aataiyeb/buck_converter/simulation/README.md

# Simulation

LTspice model of the buck converter: 12V in, 220µH inductor (0.16Ω series resistance), 220µF output
capacitor (56mΩ ESR), 10Ω load, 50kHz switching, 41.7% duty cycle.

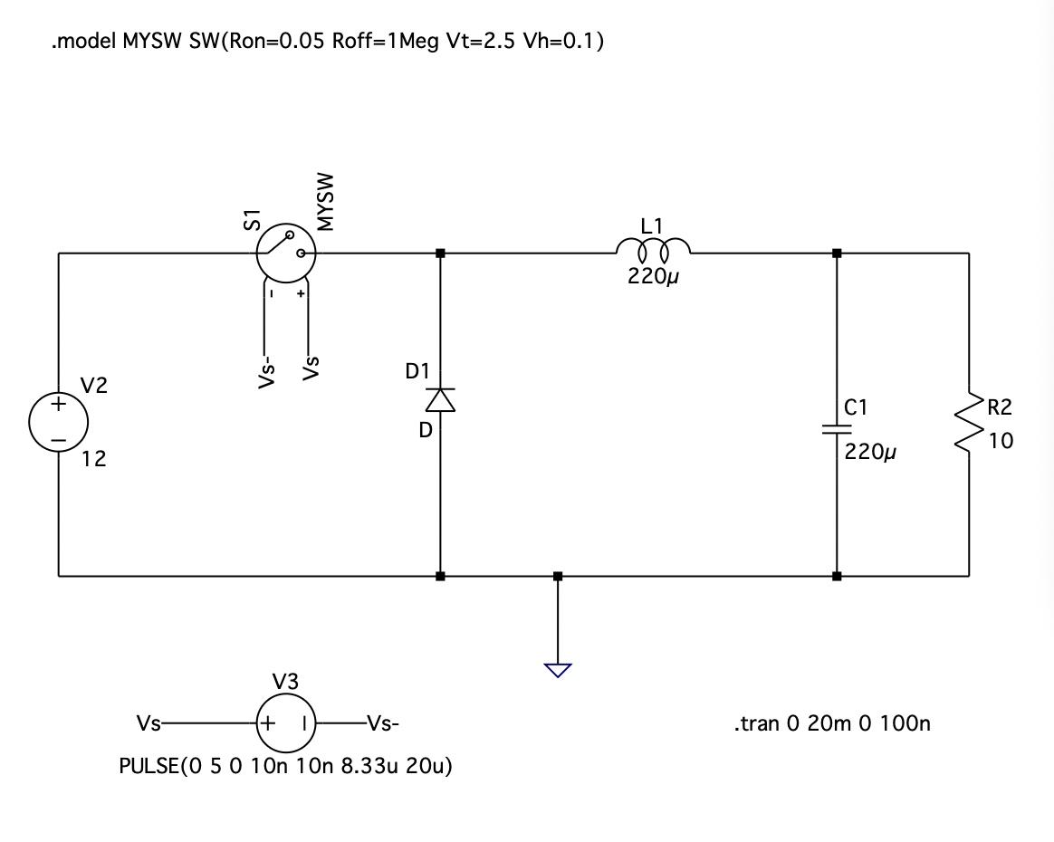
[picture p26: simulation/schematic.png]
Schematic

Schematic with the component values.

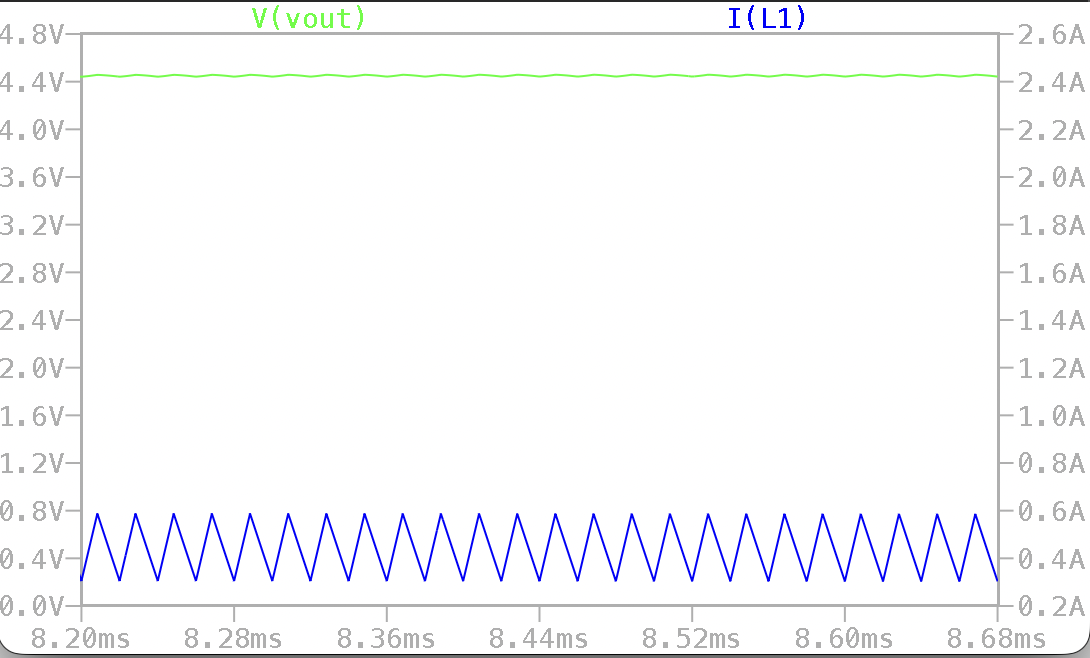
[picture p27: simulation/steady-state.png]
Steady state

Inductor current and output voltage once the output has settled.

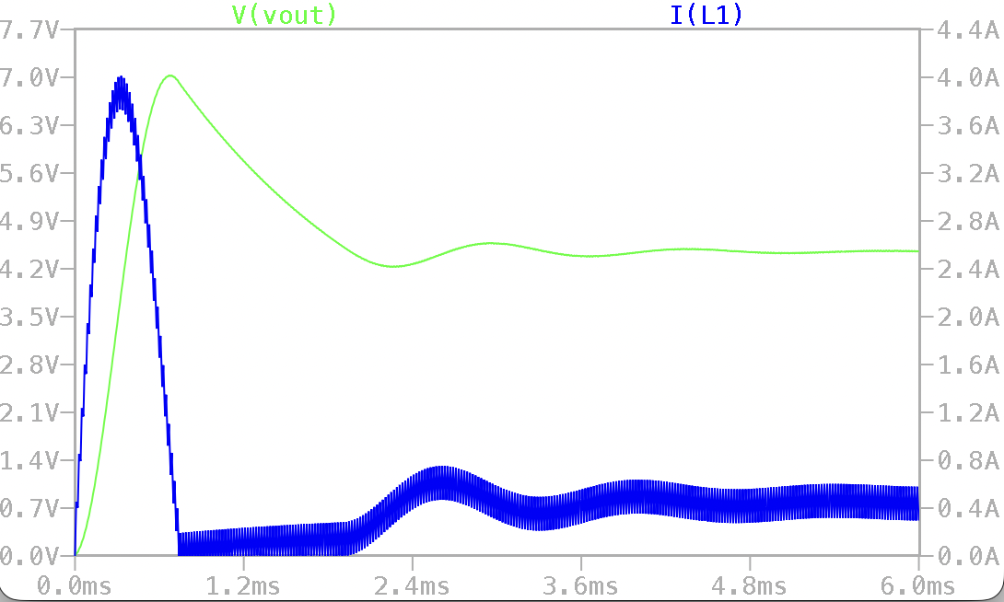
[picture p28: simulation/startup-overshoot.png]
Startup

Startup, where the output overshoots before it settles.
