aataiyeb/buck_converter/hardware/parts-inventory.jpg

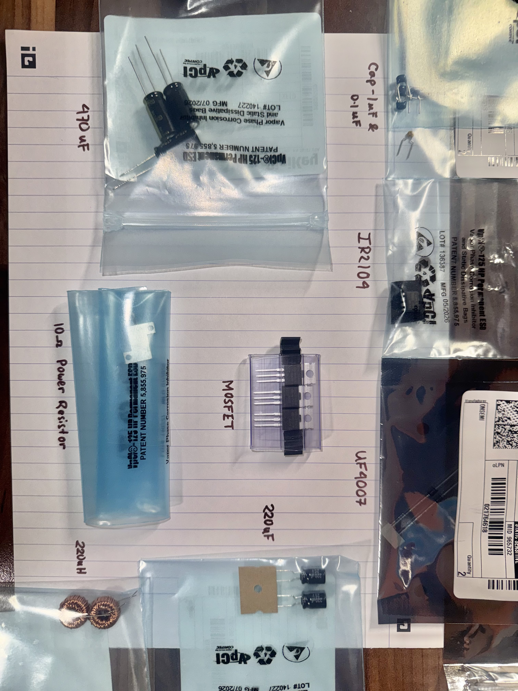
hardware/parts-inventory.jpg
