aataiyeb/buck_converter/test-data/line_regulation.csv

vin_V | vout_V | iin_A | duty_percent
11 | 4.9925 | 0.293 | 51.3
12 | 4.9878 | 0.223 | 47.3
13 | 4.9851 | 0.205 | 43.8
14 | 4.988 | 0.19 | 40.7
