aataiyeb/buck_converter/test-data/loop_startup.csv

ms | target_mV | vout_mV | duty_permille
0 | 1249 | 678 | 117
5 | 1499 | 993 | 143
10 | 1749 | 1280 | 168
15 | 1999 | 1556 | 191
20 | 2249 | 1824 | 213
25 | 2499 | 2076 | 235
30 | 2749 | 2327 | 256
35 | 2999 | 2589 | 276
40 | 3249 | 2844 | 297
45 | 3499 | 3097 | 318
50 | 3749 | 3348 | 339
55 | 3999 | 3595 | 360
60 | 4249 | 3843 | 380
65 | 4499 | 4097 | 401
70 | 4750 | 4338 | 422
75 | 5000 | 4588 | 442
80 | 5000 | 4779 | 456
85 | 5000 | 4904 | 463
90 | 5000 | 4935 | 467
95 | 5000 | 4971 | 470
100 | 5000 | 4982 | 471
105 | 5000 | 4982 | 471
110 | 5000 | 4979 | 472
115 | 5000 | 4996 | 472
120 | 5000 | 4997 | 472
125 | 5000 | 5002 | 472
130 | 5000 | 4995 | 472
135 | 5000 | 5001 | 472
140 | 5000 | 4987 | 472
145 | 5000 | 5006 | 472
150 | 5000 | 5000 | 472
155 | 5000 | 4994 | 472
160 | 5000 | 4994 | 472
165 | 5000 | 4996 | 472
170 | 5000 | 4989 | 472
175 | 5000 | 5002 | 472
180 | 5000 | 5000 | 472
185 | 5000 | 4999 | 472
190 | 5000 | 4995 | 472
195 | 5000 | 4998 | 472
200 | 5000 | 4986 | 472
205 | 5000 | 5003 | 472
210 | 5000 | 4994 | 472
215 | 5000 | 5000 | 472
220 | 5000 | 4995 | 472
225 | 5000 | 5002 | 472
230 | 5000 | 4990 | 472
235 | 5000 | 4998 | 472
240 | 5000 | 5002 | 472
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
