aataiyeb/buck_converter/simulation/buck-converter.asc

C1: Cap; 220µ; Rser=56m
D1: diode
L1: ind; 220µ; Rser=0.16
R2: Res; 10
S1: sw; MYSW
V2: Voltage; 12
V3: Voltage; PULSE(0 5 0 10n 10n 8.33u 20u)
Named nets: Vs, Vs-, 0, Vout
.model MYSW SW(Ron=0.05 Roff=1Meg Vt=2.5 Vh=0.1)
.tran 0 20m 0 100n
