aataiyeb/buck_converter/firmware/buck-firmware/Core/Src/main.c

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
/* Includes ------------------------------------------------------------------*/
#include "main.h"

/* USER CODE BEGIN Includes */
#include <stdio.h>

/* USER CODE END Includes */

/* USER CODE BEGIN PD */
#define VREF_V      3.3f      /* ADC reference voltage */
#define ADC_FULL    4095.0f   /* 12-bit full scale */
#define DIV_RATIO   0.3377f   /* 5.1k / (10k + 5.1k) */
#define V_TARGET    5.0f      /* regulated output, volts */
#define V_TRIP      5.8f      /* above this the output shuts off until RESET */
#define PWM_COUNTS  3400.0f   /* TIM1 counts per period (period register 3399 + 1) */
#define DUTY_MAX    0.55f     /* hard limit on duty cycle */
#define KP          0.002f    /* proportional gain: duty per volt of error */
#define KI          10.0f     /* integral gain: duty per volt-second */
#define TS          0.001f    /* control period in seconds (1 kHz) */

/* USER CODE END PD */


COM_InitTypeDef BspCOMInit;
ADC_HandleTypeDef hadc1;

TIM_HandleTypeDef htim1;

/* USER CODE BEGIN PV */
extern UART_HandleTypeDef hcom_uart[COMn];

/* USER CODE END PV */

void SystemClock_Config(void);
static void MX_GPIO_Init(void);
static void MX_TIM1_Init(void);
static void MX_ADC1_Init(void);
/* USER CODE BEGIN 0 */
/* Average of 16 ADC readings, scaled back up through the divider to real volts */
static float read_vout(void)
{
  uint32_t sum = 0;
  for (int i = 0; i < 16; i++)
  {
    HAL_ADC_Start(&hadc1);
    HAL_ADC_PollForConversion(&hadc1, 1);
    sum += HAL_ADC_GetValue(&hadc1);
  }
  float v_pin = ((float)sum / 16.0f) * VREF_V / ADC_FULL;
  return v_pin / DIV_RATIO;
}

/* Set the PWM duty cycle as a fraction, 0.0 to 1.0 */
static void set_duty(float duty)
{
  __HAL_TIM_SET_COMPARE(&htim1, TIM_CHANNEL_1, (uint32_t)(duty * PWM_COUNTS));
}
/* USER CODE END 0 */

/**
  * @brief  The application entry point.
  * @retval int
  */
int main(void)
{

  /* MCU Configuration--------------------------------------------------------*/

  /* Reset of all peripherals, Initializes the Flash interface and the Systick. */
  HAL_Init();

  /* Configure the system clock */
  SystemClock_Config();

  /* Initialize all configured peripherals */
  MX_GPIO_Init();
  MX_TIM1_Init();
  MX_ADC1_Init();
  /* USER CODE BEGIN 2 */
  HAL_ADCEx_Calibration_Start(&hadc1, ADC_SINGLE_ENDED);
  set_duty(0.0f);
  HAL_TIM_PWM_Start(&htim1, TIM_CHANNEL_1);

  float vref = 0.0f;        /* target voltage, ramped up slowly (soft start) */
  float integral = 0.0f;    /* running total for the integral term */
  float duty = 0.0f;
  uint8_t tripped = 0;
  uint32_t last_tick = HAL_GetTick();
  uint32_t loop_count = 0;

  /* Enable the gate driver only now. PWM is running at 0 % and the output is at 0 V.
     Through reset and boot, the pull-down on pin 3 keeps the driver off. */
  HAL_GPIO_WritePin(SD_EN_GPIO_Port, SD_EN_Pin, GPIO_PIN_SET);
  /* USER CODE END 2 */

  /* Initialize led */
  BSP_LED_Init(LED_GREEN);

  /* Initialize USER push-button, will be used to trigger an interrupt each time it's pressed.*/
  BSP_PB_Init(BUTTON_USER, BUTTON_MODE_EXTI);

  /* Initialize COM1 port (115200, 8 bits (7-bit data + 1 stop bit), no parity */
  BspCOMInit.BaudRate   = 115200;
  BspCOMInit.WordLength = COM_WORDLENGTH_8B;
  BspCOMInit.StopBits   = COM_STOPBITS_1;
  BspCOMInit.Parity     = COM_PARITY_NONE;
  BspCOMInit.HwFlowCtl  = COM_HWCONTROL_NONE;
  if (BSP_COM_Init(COM1, &BspCOMInit) != BSP_ERROR_NONE)
  {
    Error_Handler();
  }

  /* Infinite loop */
  /* USER CODE BEGIN WHILE */
  while (1)
  {

    /* USER CODE END WHILE */

    /* USER CODE BEGIN 3 */
	  if (HAL_GetTick() - last_tick >= 1)          /* runs once per millisecond */
	  {
	    last_tick++;
	    loop_count++;

	    float vout = read_vout();

	    if (vout > V_TRIP)
	    {
	      tripped = 1;                             /* latched until RESET */
	    }

	    if (tripped)
	    {
	      HAL_GPIO_WritePin(SD_EN_GPIO_Port, SD_EN_Pin, GPIO_PIN_RESET);   /* driver off: both MOSFETs off */
	      duty = 0.0f;
	      integral = 0.0f;
	      HAL_GPIO_WritePin(LED2_GPIO_PORT, LED2_PIN, GPIO_PIN_SET);       /* LED solid = tripped */
	    }
	    else
	    {
	      if (vref < V_TARGET) vref += 0.05f;      /* soft start: 0 to 5 V over 100 ms */
	      if (vref > V_TARGET) vref = V_TARGET;

	      float error = vref - vout;
	      integral += KI * TS * error;
	      if (integral < 0.0f)     integral = 0.0f;
	      if (integral > DUTY_MAX) integral = DUTY_MAX;   /* anti-windup */

	      duty = KP * error + integral;
	      if (duty < 0.0f)     duty = 0.0f;
	      if (duty > DUTY_MAX) duty = DUTY_MAX;

	      if (loop_count % 250 == 0) HAL_GPIO_TogglePin(LED2_GPIO_PORT, LED2_PIN);  /* heartbeat */
	    }

	    set_duty(duty);

	    if (loop_count % 5 == 0)                   /* log 200 lines per second */
	    {
	      char msg[40];
	      int n = snprintf(msg, sizeof(msg), "%lu,%d,%d,%d\r\n", (unsigned long)HAL_GetTick(),
	                       (int)(vref * 1000.0f), (int)(vout * 1000.0f), (int)(duty * 1000.0f));
	      HAL_UART_Transmit(&hcom_uart[COM1], (uint8_t *)msg, n, 10);
	    }
	  }
  }
  /* USER CODE END 3 */
}

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
