aataiyeb/buck_converter/firmware/buck-firmware/buck-firmware.ioc

Mcu.UserName=STM32G474RETx
PA0.Signal=ADC1_IN1
PA13.GPIO_Label=T_SWDIO
PA13.Signal=SYS_JTMS-SWDIO
PA14.GPIO_Label=T_SWCLK
PA14.Signal=SYS_JTCK-SWCLK
PA2.Signal=LPUART1_TX
PA3.Signal=LPUART1_RX
PA8.Signal=S_TIM1_CH1
PA9.GPIO_Label=SD_EN
PA9.Signal=GPIO_Output
PB3.GPIO_Label=T_SWO
PB3.Signal=SYS_JTDO-SWO
PC14-OSC32_IN.GPIO_Label=RCC_OSC32_IN
PC14-OSC32_IN.Signal=RCC_OSC32_IN
PC15-OSC32_OUT.GPIO_Label=RCC_OSC32_OUT
PC15-OSC32_OUT.Signal=RCC_OSC32_OUT
PF0-OSC_IN.GPIO_Label=RCC_OSC_IN
PF0-OSC_IN.Signal=RCC_OSC_IN
PF1-OSC_OUT.GPIO_Label=RCC_OSC_OUT
PF1-OSC_OUT.Signal=RCC_OSC_OUT
