aataiyeb/buck_converter/(commit log)

2026-10-10 Added LED blink firmware, README and log
2026-10-10 Added 50 kHz PWM on TIM1
2026-10-18 Added power stage results at 12 V
2026-10-19 Added synchronous stage with shutdown control and results
